iamlab-cmu/delta-arrays/cad/Linear Servo Motor.png

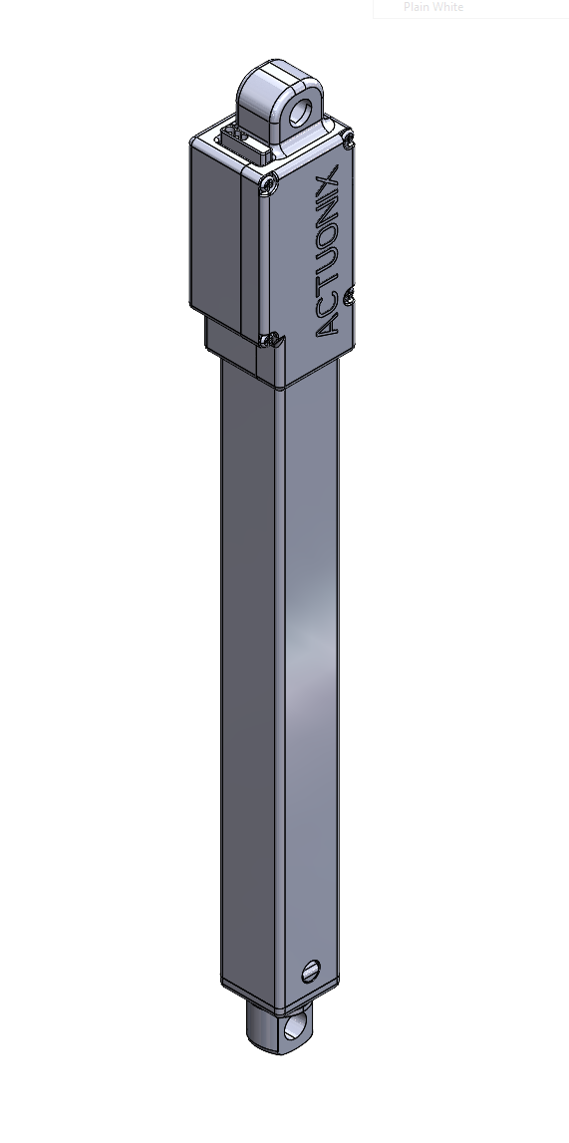
cad/Linear Servo Motor.png
