iamlab-cmu/delta-arrays/cad/spacers1.png

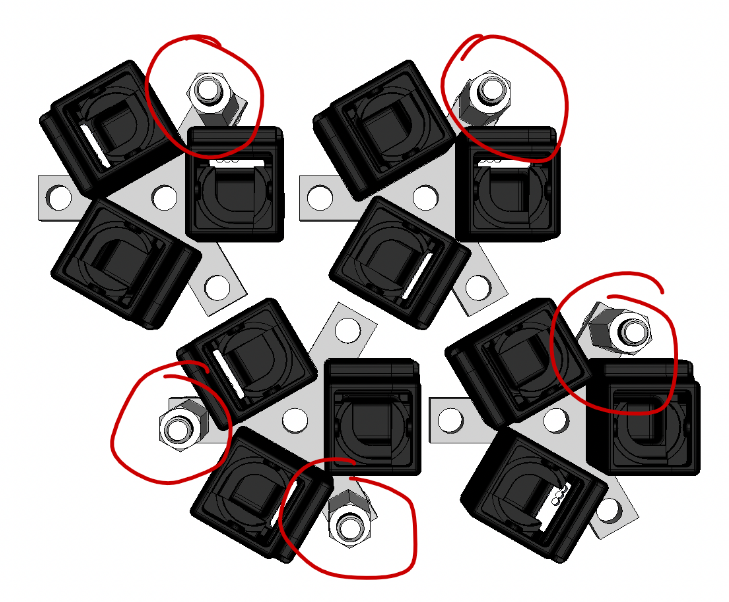
cad/spacers1.png
