iamlab-cmu/delta-arrays/cad/top_plate2x2.dxf

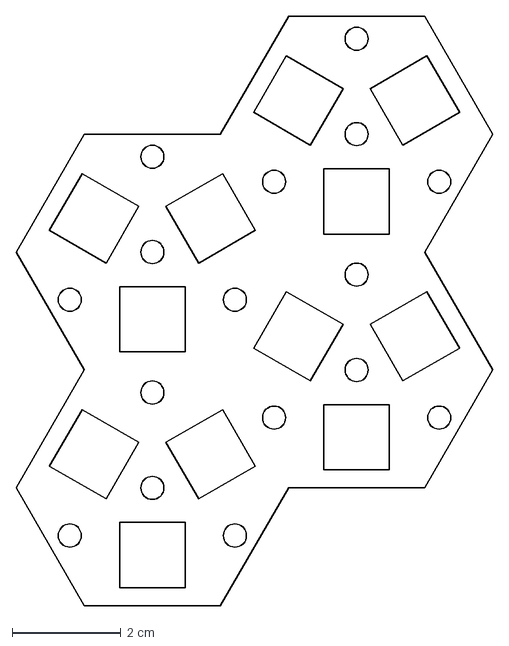
[picture p14: CAD file, 2022-11-01]
cad/top_plate2x2.dxf
8.75 x 10.8 cm
