iamlab-cmu/delta-arrays/cad/top_plate.dxf

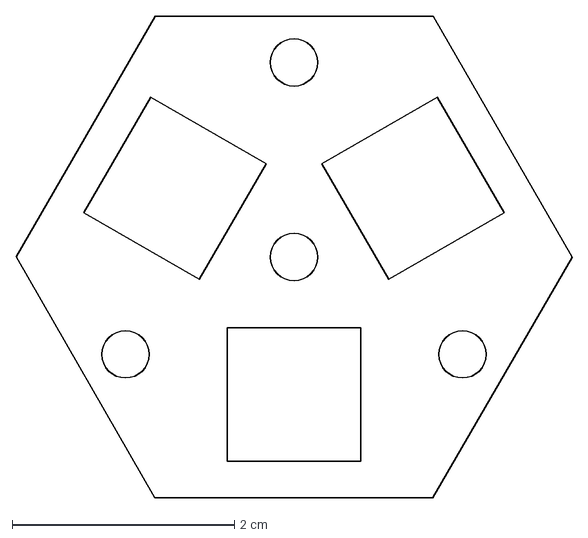
[picture p15: CAD file, 2022-10-13]
cad/top_plate.dxf
5.00 x 4.33 cm
