iamlab-cmu/delta-arrays/cad/FDM Printed Enclosure.STEP

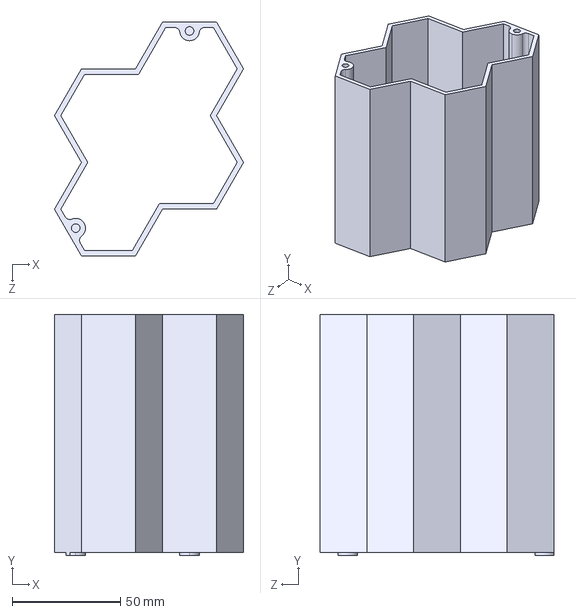
[picture p16: CAD file, 2022-10-13]
cad/FDM Printed Enclosure.STEP
87.5 x 111.5 x 108.3 mm
