iamlab-cmu/delta-arrays/cad/FDM Printed Fingertip Bone.STEP

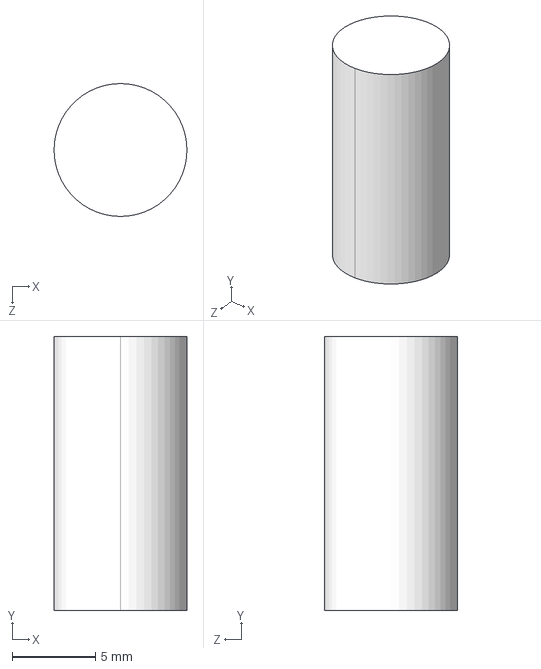
[picture p17: CAD file, 2022-10-13]
cad/FDM Printed Fingertip Bone.STEP
8.00 x 16.5 x 8.00 mm
