iamlab-cmu/delta-arrays/cad/FDM Printed Delta Link.STEP

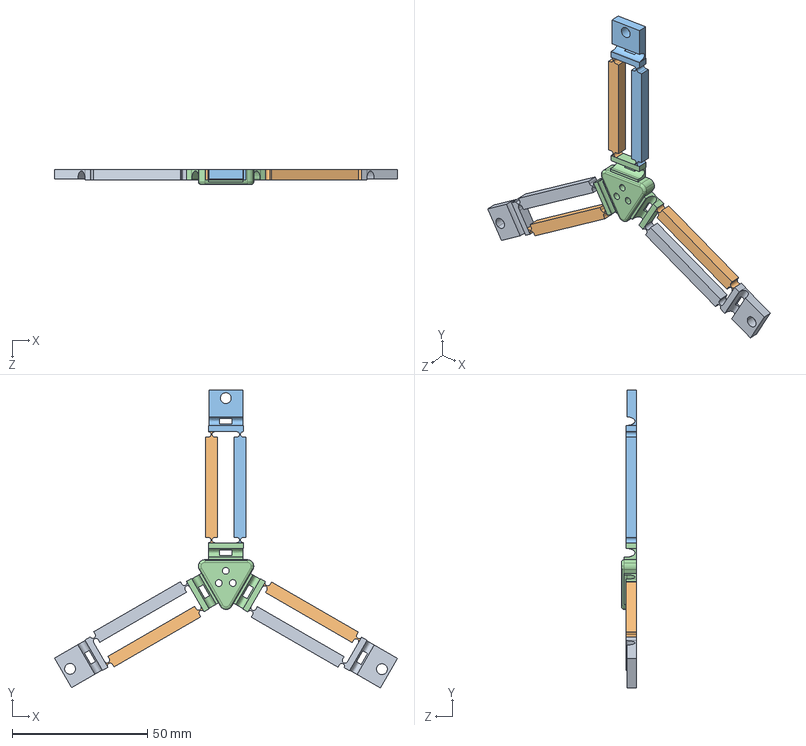
[picture p18: CAD file, 2022-10-13]
cad/FDM Printed Delta Link.STEP
126.7 x 110.0 x 5.60 mm
