iamlab-cmu/delta-arrays/cad/SLA Printed Fingertip Clip.STEP

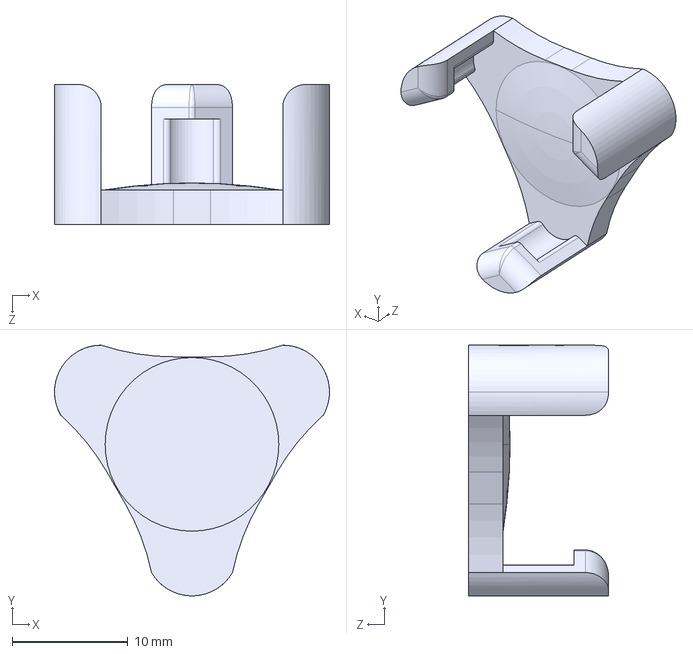
[picture p19: CAD file, 2022-10-13]
cad/SLA Printed Fingertip Clip.STEP
23.8 x 21.6 x 12.1 mm
