iamlab-cmu/delta-arrays/cad/FDM Printed Star Shaped Mount.STEP

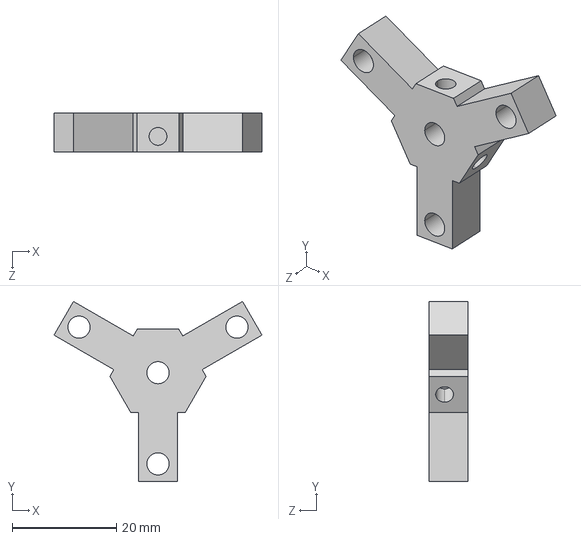
[picture p20: CAD file, 2022-10-13]
cad/FDM Printed Star Shaped Mount.STEP
39.9 x 34.6 x 7.50 mm
