iamlab-cmu/delta-arrays/cad/Linear Servo Motor.STEP

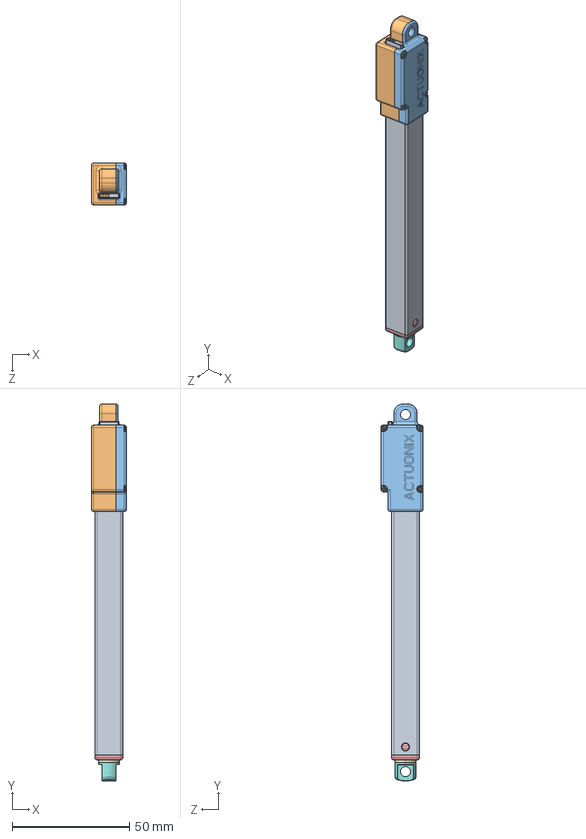
[picture p21: CAD file, 2022-10-13]
cad/Linear Servo Motor.STEP
15.1 x 161.0 x 18.0 mm
EXTENSION_10405_100MM.stp
CLAMSHELL_BOT_10417.stp
CLAMSHELL_TOP_10416.stp
FASTENER_10427.stp x 4
GUIDE_10429.stp
NUT_10419.stp
SHAFT_10410_100MM.stp
PLUG_10428.stp
GROMMET_3_HOLE.stp
