iamlab-cmu/delta-arrays/cad/Fingertip Outer.STEP

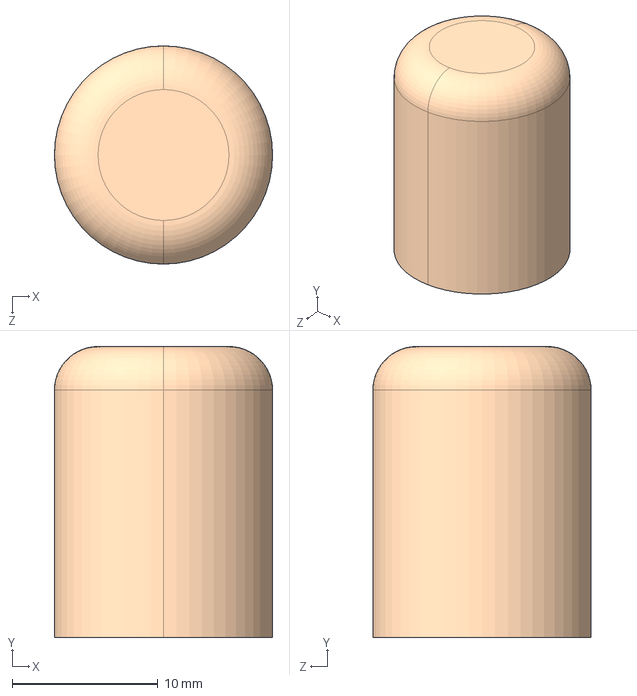
[picture p22: CAD file, 2022-10-13]
cad/Fingertip Outer.STEP
15.0 x 20.0 x 15.0 mm
