iamlab-cmu/delta-arrays/cad/FDM Printed Enclosure.PNG

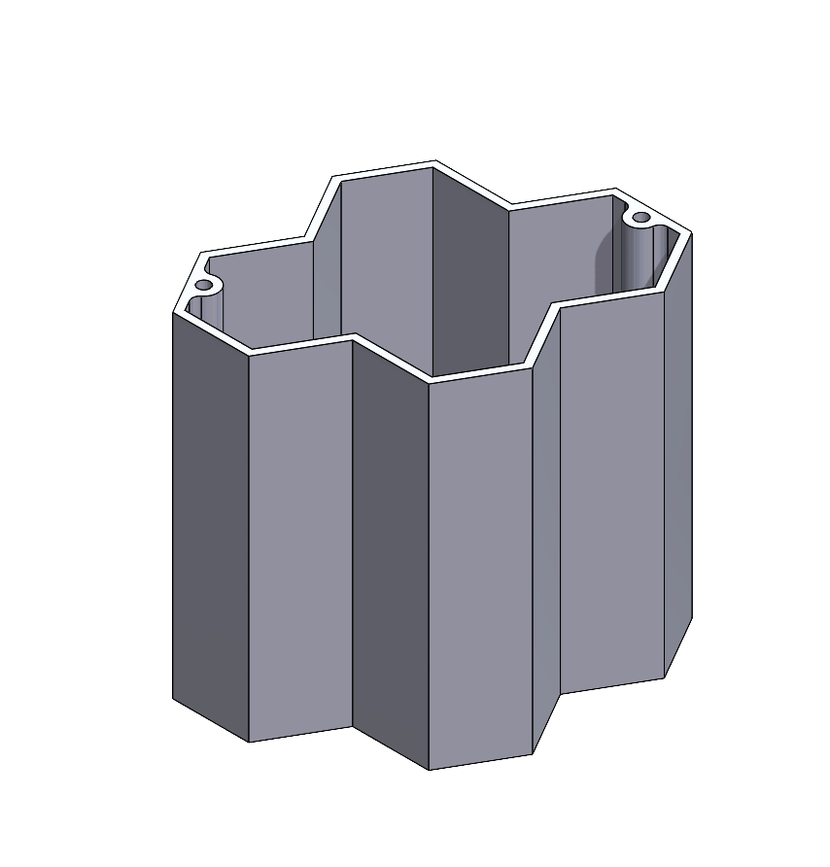
cad/FDM Printed Enclosure.PNG
