iamlab-cmu/delta-arrays/cad/FDM Printed Fingertip Bone.png

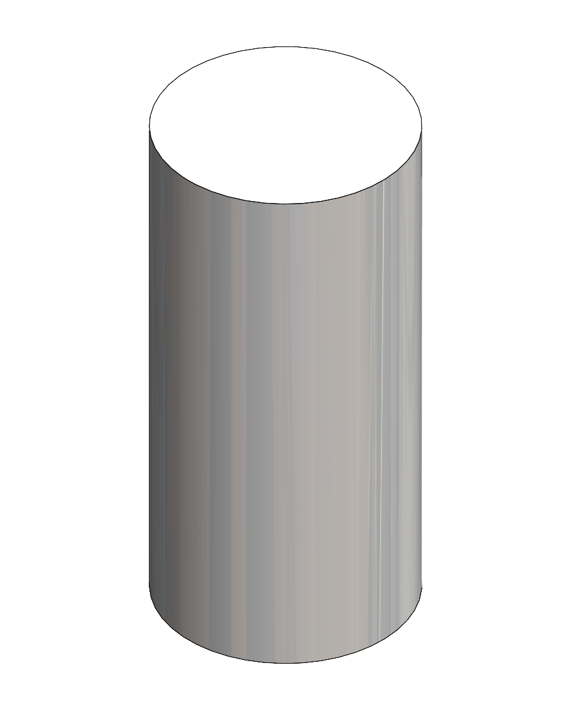
cad/FDM Printed Fingertip Bone.png
