iamlab-cmu/delta-arrays/(commit log)

2022-10-13 Updated website
    [FDM Printed Delta Link.STEP, FDM Printed Enclosure.STEP, FDM Printed Fingertip Bone.STEP, FDM Printed Star Shaped Mount.STEP, Fingertip Outer.STEP, Linear Servo Motor.STEP, SLA Printed Fingertip Clip.STEP, top_plate.dxf]
2022-11-01 2x2 module
    [top_plate2x2.dxf]
